CatoLynx/LAWO-Arduino/BOM.xlsx

Item | Qty | Reference(s) | Value | Order No. / URL | Supplier
1 | 3 | C3,C1,C4 | 100n | X7R-5 100N | reichelt
2 | 1 | C2 | 100u | RAD 100/25 | reichelt
3 | 1 | F1 | T500mA | RND 170-00041 | reichelt
4 | 1 | P1,P2 | POWER/DATA,LED | AKL 230-04 + AKL 249-04 | reichelt
5 | 1 | P3 | MATRIX | WSL 50G | reichelt
6 | 1 | P4 | MUX | WSL 20G | reichelt
7 | 1 | Q1 | BC547 | BC 547C | reichelt
8 | 1 | Q2 | IRF740 | IRF 740 | reichelt
9 | 4 | R5,R6,R1,R2 | 10k | 1/4W 10K | reichelt
10 | 1 | R3 | 240 | 1/4W 240 | reichelt
11 | 1 | R4 | 56 | 2W METALL 56 | reichelt
12 | 1 | RV1 | 5k | 64Y-5,0K | reichelt
13 | 1 | U1 | R-78E5.0-0.5 | R-78E50-05 | reichelt
14 | 1 | U2 | LM317T | LM 317-220 | reichelt
15 | 2 | U9,U3 | CD4514B | https://www.ebay.de/itm/110545119205 | eBay
16 | 2 | U5,U4 | ULN2803A | ULN 2803A | reichelt
17 | 1 | U6 | Arduino_Nano | https://www.ebay.de/itm/252742123829 | eBay
18 | 2 | U7,U8 | UDN2981A | UDN 2981 | reichelt
19 | 4 | U4,U5,U7,U8 | Sockel | GS 18 | reichelt
20 | 2 | U3,U9 | Sockel | GS 24 | reichelt
21 | 2 | U6 | Sockel | https://www.ebay.de/itm/172461135540 | eBay
22 | 1 | Q2 | Kühlkörper | 188158 | Conrad
