CatoLynx/LAWO-Arduino/Eigene Steuerplatine Line Decoder.pdf

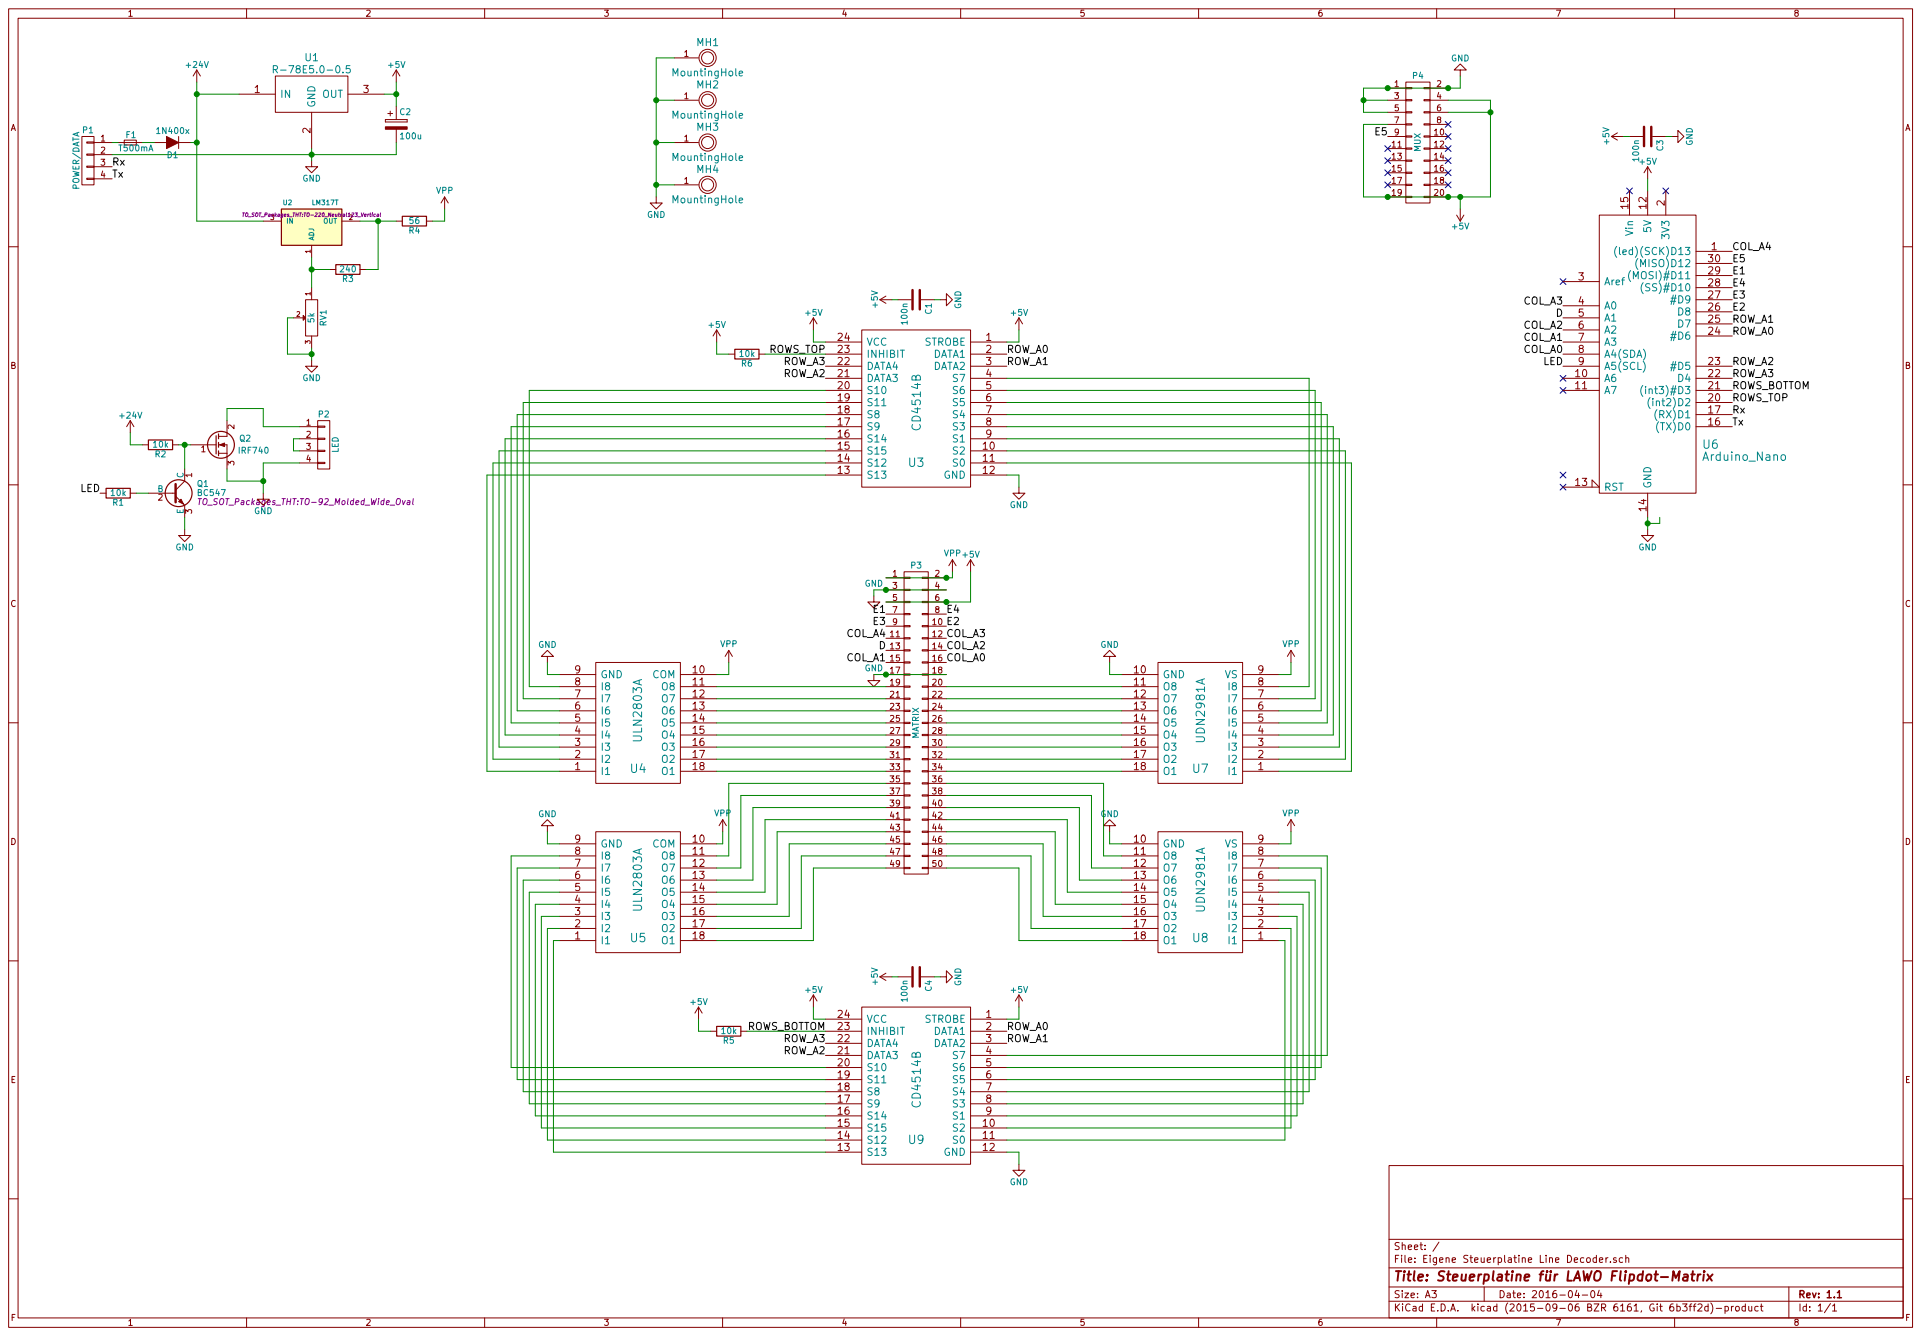
[picture p1: page 1]

10k +5V 1 MH1 MountingHole 1 MH2 MountingHole 1 MH3 MountingHole 1 MH4 MountingHole GND

COL_A2

21 | | 22
23 | | 24
25 | | 26
27 | | 28
29 | | 30
31 | | 32
33 | | 34
35 | | 36
37 | | 38
39 | | 40
41 | | 42
43 | | 44
45 | | 46
47 | | 48

Id: 1/1 Title: Steuerplatine für LAWO Flipdot-Matrix
