CatoLynx/LAWO-Arduino/Eigene Steuerplatine Line Decoder.kicad_pcb

## KiCad design Eigene Steuerplatine Line Decoder.kicad_pcb (2023-11-21)

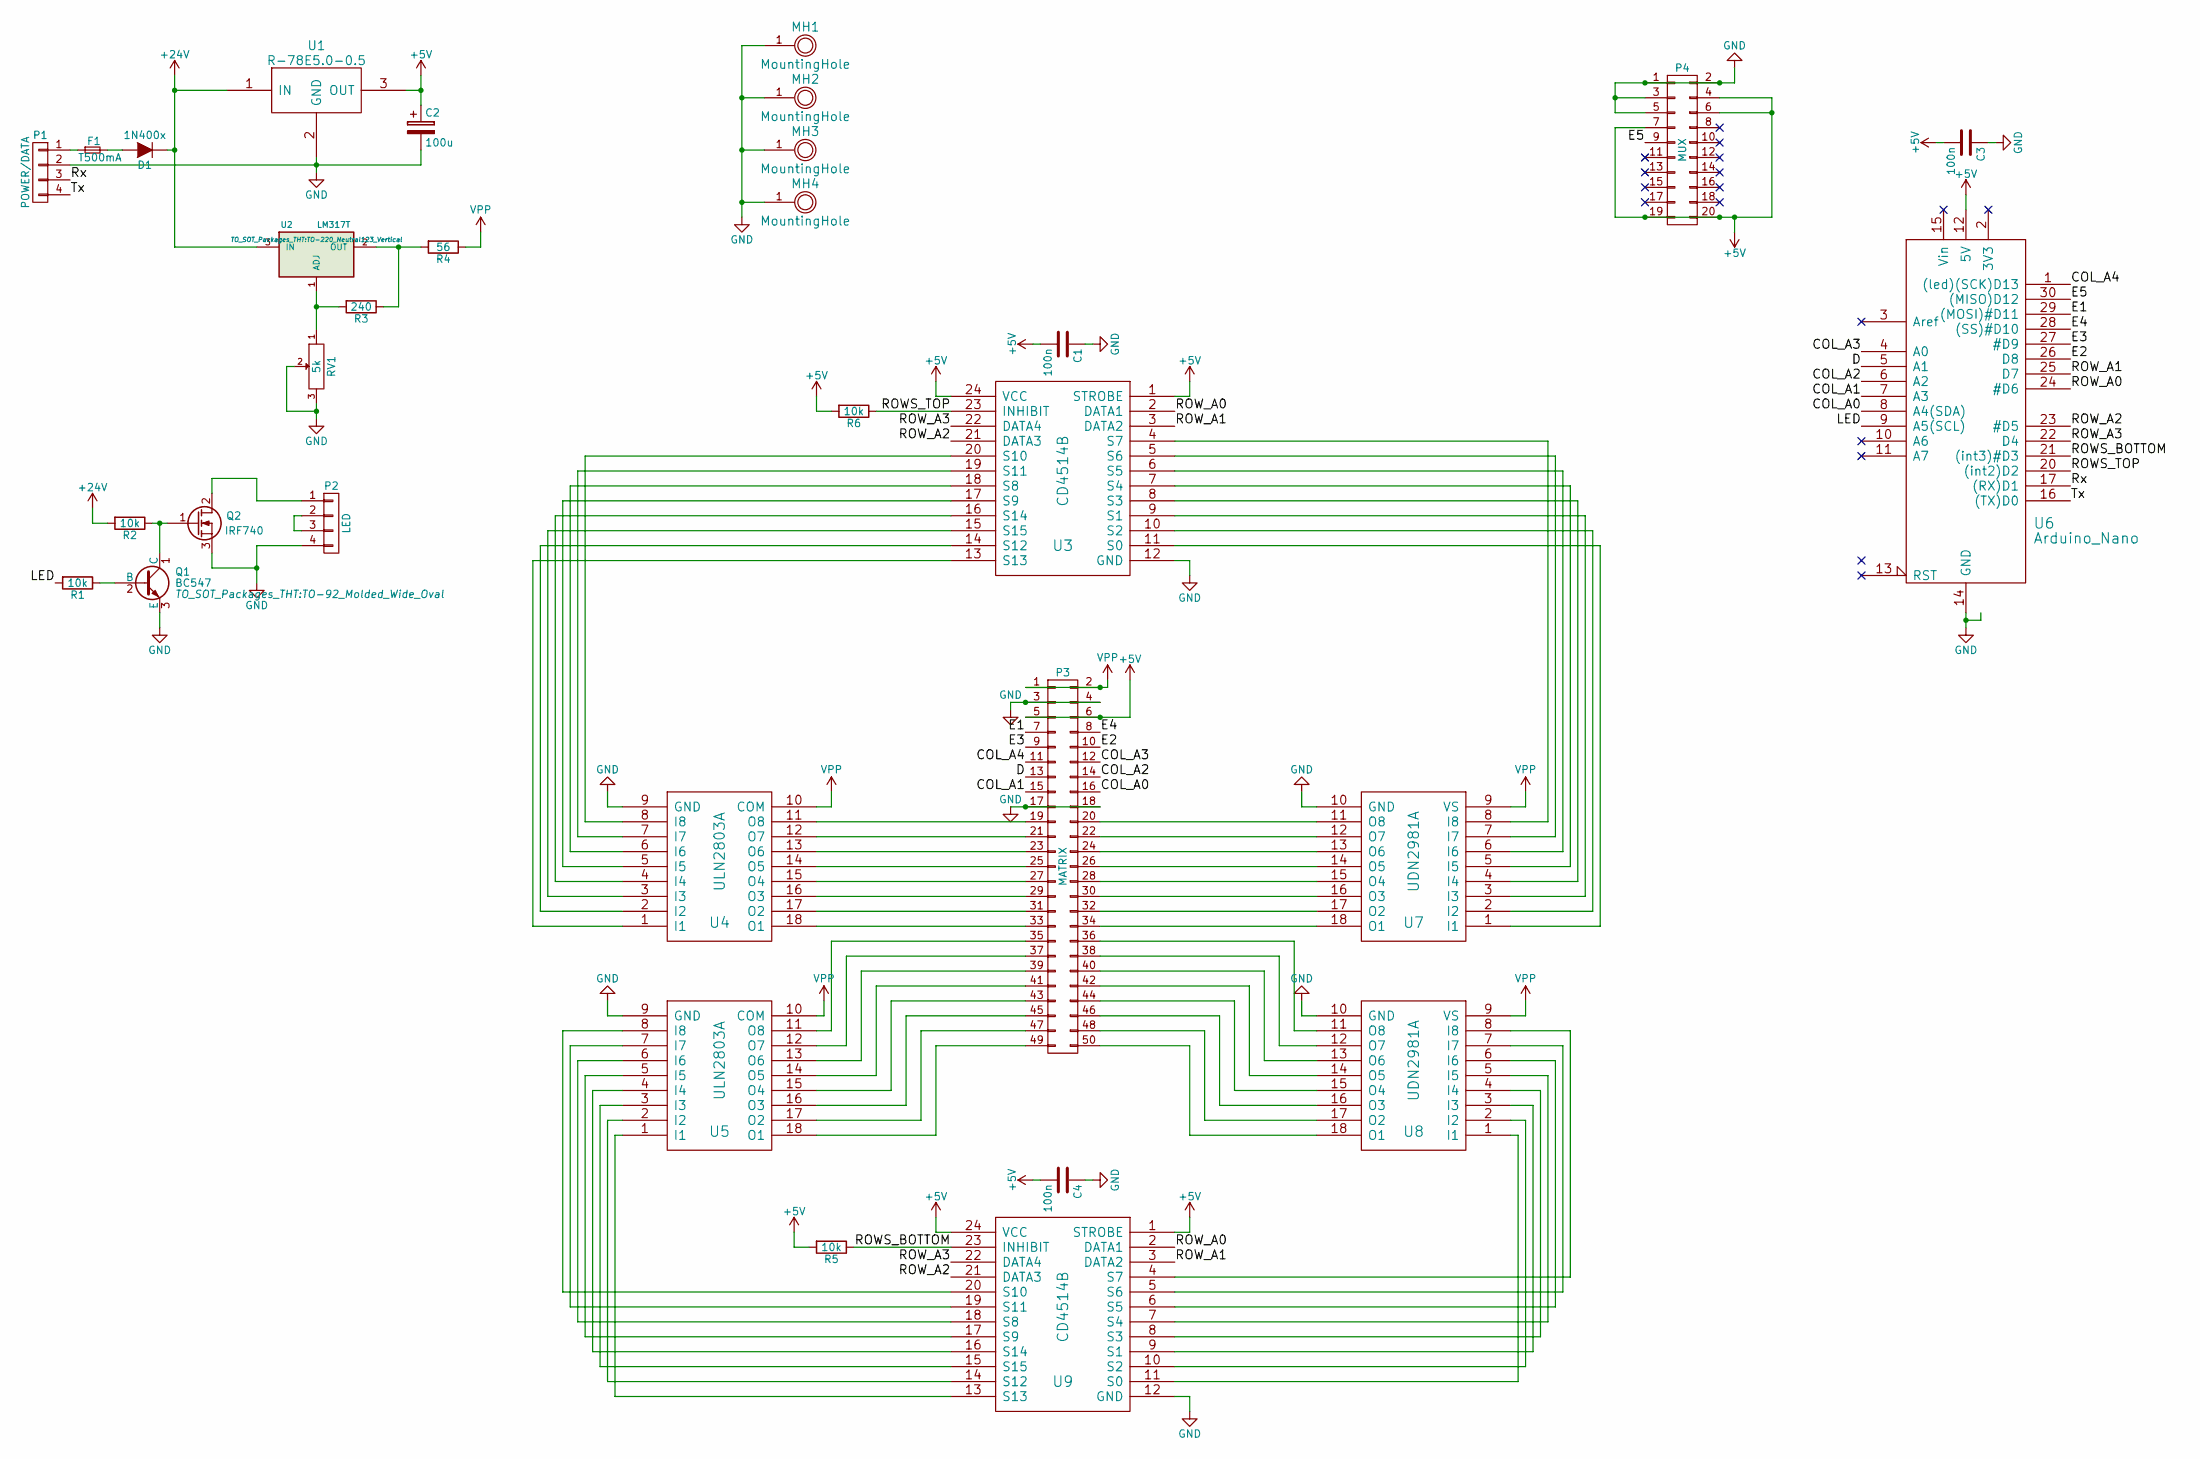
[picture p2: schematic Eigene Steuerplatine Line Decoder.kicad_sch, Steuerplatine für LAWO Flipdot-Matrix]

Parts:
C1, C3, C4: 100n; C_Rect_L7_W2.5_P5
C2: 100u; C_Radial_D5_L11_P2.5
D1: 1N400x; Diode_DO-35_SOD27_Horizontal_RM10
F1: T500mA; Fuseholder5x20_horiz_open_Schurter_0031_8201
MH1, MH2, MH3, MH4: MountingHole; 1pin
P1: POWER/DATA; Terminal_Conn_4pin_RM5.08
P2: LED; Terminal_Conn_4pin_RM5.08
P3: MATRIX; IDC_Header_Straight_50pins
P4: MUX; IDC_Header_Straight_20pins
Q1: BC547; TO-92_Molded_Wide_Oval
Q2: IRF740; TO-220_Neutral123_Vertical
R1, R2, R5, R6: 10k; Resistor_Horizontal_RM10mm
R3: 240; Resistor_Horizontal_RM10mm
R4: 56; Resistor_Horizontal_RM20mm
RV1: 5k; Potentiometer_Bourns_3296Y_3-8Zoll_Angular_ScrewUp
U1: R-78E5.0-0.5; DC_DC_Converter_W11.5_L8.5_P2.54
U2: LM317T; TO-220_Neutral123_Vertical
U3, U9: CD4514B; DIP-24_W15.24mm_LongPads
U4, U5: ULN2803A; DIP-18_W7.62mm_LongPads
U6: Arduino_Nano
U7, U8: UDN2981A; DIP-18_W7.62mm_LongPads

Connections:
+5V: C1.2, C2.1, C3.2, C4.2, P3.5, P3.6, P4.4, P4.6, P4.7, P4.19, P4.20, R5.2, R6.2, U1.3 (OUT), U3.1 (STROBE), U3.24 (VCC), U6.12 (5V), U9.1 (STROBE), U9.24 (VCC)
+24V: D1.1 (K), D1.2 (A), F1.2, R2.2, U1.1 (IN), U2.3 (IN)
/COL_A0: P3.16, U6.8 (A4(SDA))
/COL_A1: P3.15, U6.7 (A3)
/COL_A2: P3.14, U6.6 (A2)
/COL_A3: P3.12, U6.4 (A0)
/COL_A4: P3.11, U6.1 ((led)(SCK)D13)
/D: P3.13, U6.5 (A1)
/E1: P3.7, U6.29 ((MOSI)#D11)
/E2: P3.10, U6.26 (D8)
/E3: P3.9, U6.27 (#D9)
/E4: P3.8, U6.28 ((SS)#D10)
/E5: P4.9, U6.30 ((MISO)D12)
/LED: R1.2, U6.9 (A5(SCL))
/ROWS_BOTTOM: R5.1, U6.21 ((int3)#D3), U9.23 (INHIBIT)
/ROWS_TOP: R6.1, U3.23 (INHIBIT), U6.20 ((int2)D2)
/ROW_A0: U3.2 (DATA1), U6.24 (#D6), U9.2 (DATA1)
/ROW_A1: U3.3 (DATA2), U6.25 (D7), U9.3 (DATA2)
/ROW_A2: U3.21 (DATA3), U6.23 (#D5), U9.21 (DATA3)
/ROW_A3: U3.22 (DATA4), U6.22 (D4), U9.22 (DATA4)
/Rx: P1.3, U6.17 ((RX)D1)
/Tx: P1.4, U6.16 ((TX)D0)
GND: C1.1, C2.2, C3.1, C4.1, MH1.1, MH2.1, MH3.1, MH4.1, P1.2, P2.4, P3.3, P3.4, P3.17, P3.18, P4.1, P4.2, P4.3, P4.5, Q1.3 (E), Q2.3 (S), RV1.2, RV1.3, U1.2 (GND), U3.12 (GND), U4.9 (GND), U5.9 (GND), U6.14 (GND), U6.19 (GND), U7.10 (GND), U8.10 (GND), U9.12 (GND)
unnamed: F1.1, P1.1
unnamed: P2.1, Q2.2 (D)
unnamed: P2.2, P2.3
unnamed: P3.19, U4.11 (O8)
unnamed: P3.20, U7.11 (O8)
unnamed: P3.21, U4.12 (O7)
unnamed: P3.22, U7.12 (O7)
unnamed: P3.23, U4.13 (O6)
unnamed: P3.24, U7.13 (O6)
unnamed: P3.25, U4.14 (O5)
unnamed: P3.26, U7.14 (O5)
unnamed: P3.27, U4.15 (O4)
unnamed: P3.28, U7.15 (O4)
unnamed: P3.29, U4.16 (O3)
unnamed: P3.30, U7.16 (O3)
unnamed: P3.31, U4.17 (O2)
unnamed: P3.32, U7.17 (O2)
unnamed: P3.33, U4.18 (O1)
unnamed: P3.34, U7.18 (O1)
unnamed: P3.35, U5.11 (O8)
unnamed: P3.36, U8.11 (O8)
unnamed: P3.37, U5.12 (O7)
unnamed: P3.38, U8.12 (O7)
unnamed: P3.39, U5.13 (O6)
unnamed: P3.40, U8.13 (O6)
unnamed: P3.41, U5.14 (O5)
unnamed: P3.42, U8.14 (O5)
unnamed: P3.43, U5.15 (O4)
unnamed: P3.44, U8.15 (O4)
unnamed: P3.45, U5.16 (O3)
unnamed: P3.46, U8.16 (O3)
unnamed: P3.47, U5.17 (O2)
unnamed: P3.48, U8.17 (O2)
unnamed: P3.49, U5.18 (O1)
unnamed: P3.50, U8.18 (O1)
unnamed: Q1.1 (C), Q2.1 (G), R2.1
unnamed: Q1.2 (B), R1.1
unnamed: R3.1, R4.2, U2.2 (OUT)
unnamed: R3.2, RV1.1, U2.1 (ADJ)
unnamed: U3.4 (S7), U7.8 (I8)
unnamed: U3.5 (S6), U7.7 (I7)
unnamed: U3.6 (S5), U7.6 (I6)
unnamed: U3.7 (S4), U7.5 (I5)
unnamed: U3.8 (S3), U7.4 (I4)
unnamed: U3.9 (S1), U7.3 (I3)
unnamed: U3.10 (S2), U7.2 (I2)
unnamed: U3.11 (S0), U7.1 (I1)
unnamed: U3.13 (S13), U4.1 (I1)
unnamed: U3.14 (S12), U4.2 (I2)
unnamed: U3.15 (S15), U4.3 (I3)
unnamed: U3.16 (S14), U4.4 (I4)
unnamed: U3.17 (S9), U4.5 (I5)
unnamed: U3.18 (S8), U4.6 (I6)
unnamed: U3.19 (S11), U4.7 (I7)
unnamed: U3.20 (S10), U4.8 (I8)
unnamed: U5.1 (I1), U9.13 (S13)
unnamed: U5.2 (I2), U9.14 (S12)
unnamed: U5.3 (I3), U9.15 (S15)
unnamed: U5.4 (I4), U9.16 (S14)
unnamed: U5.5 (I5), U9.17 (S9)
unnamed: U5.6 (I6), U9.18 (S8)
unnamed: U5.7 (I7), U9.19 (S11)
unnamed: U5.8 (I8), U9.20 (S10)
unnamed: U8.1 (I1), U9.11 (S0)
unnamed: U8.2 (I2), U9.10 (S2)
unnamed: U8.3 (I3), U9.9 (S1)
unnamed: U8.4 (I4), U9.8 (S3)
unnamed: U8.5 (I5), U9.7 (S4)
unnamed: U8.6 (I6), U9.6 (S5)
unnamed: U8.7 (I7), U9.5 (S6)
unnamed: U8.8 (I8), U9.4 (S7)
VPP: P3.1, P3.2, R4.1, U4.10 (COM), U5.10 (COM), U7.9 (VS), U8.9 (VS)

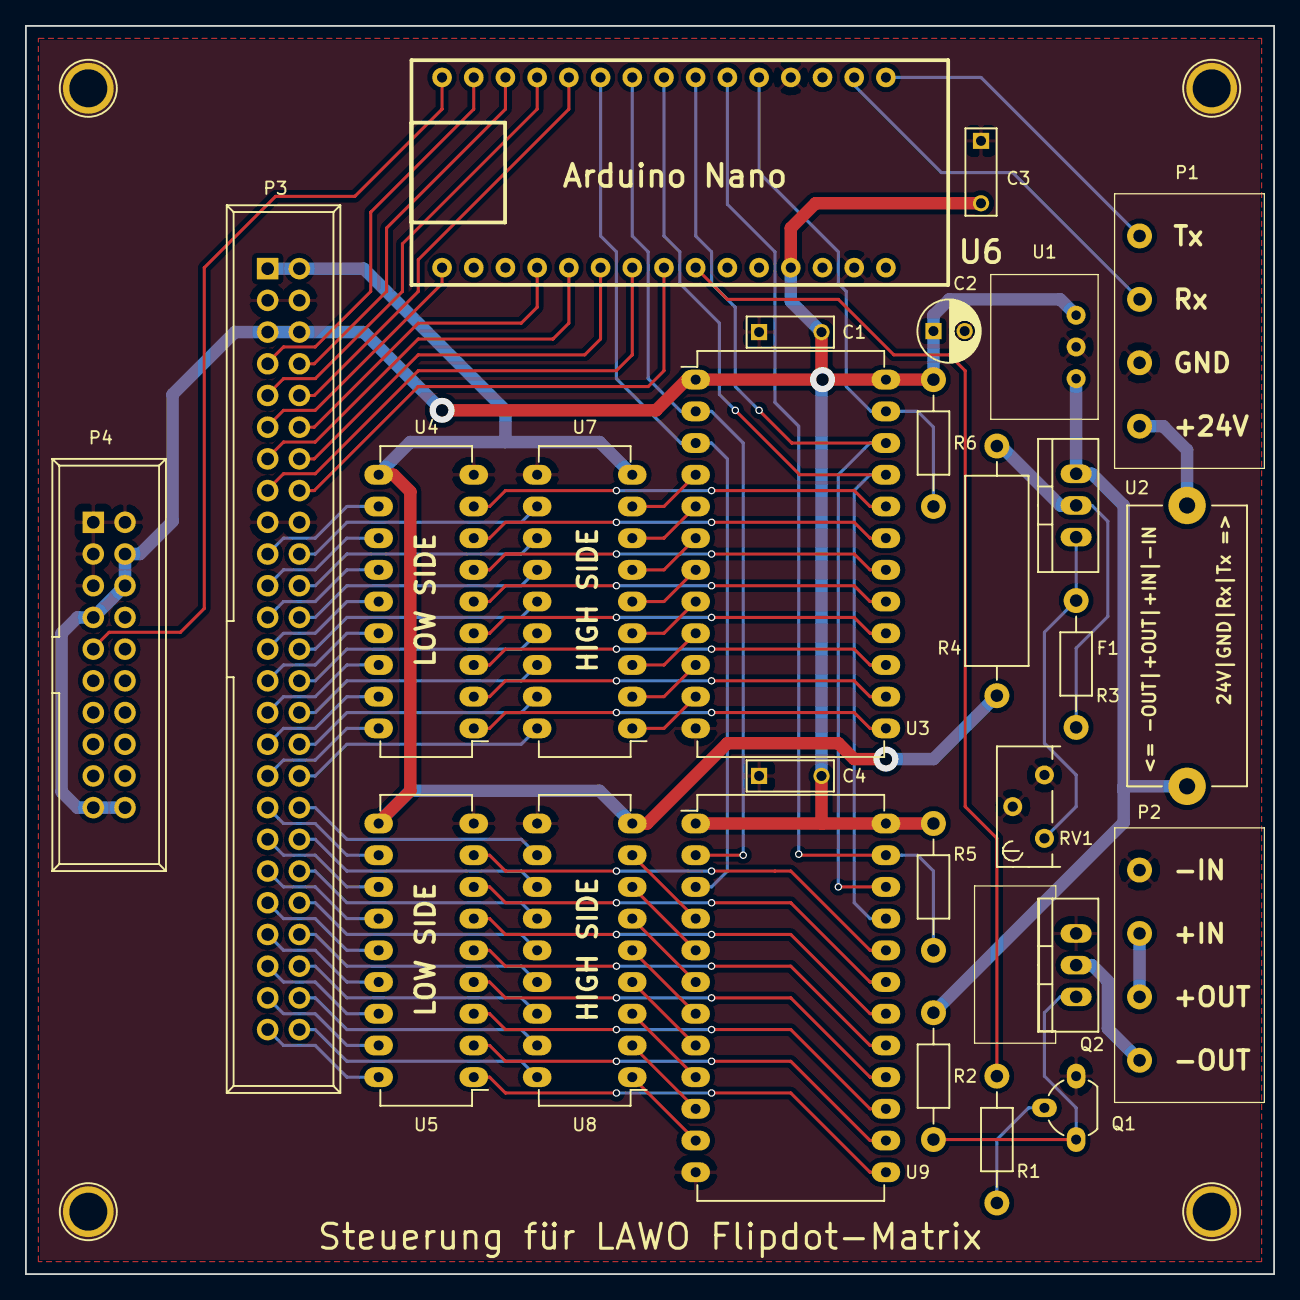
[picture p3: board Eigene Steuerplatine Line Decoder.kicad_pcb from above]

Board: 2 copper layers, 100.0 x 100.0 mm, 31 parts (0 on the bottom side), 95 nets.
