CatoLynx/LAWO-Arduino/(commit log)

2020-04-20 Initial version
    [Eigene Steuerplatine Line Decoder.csv, Eigene Steuerplatine Line Decoder.kicad_pcb, Eigene Steuerplatine Line Decoder.sch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]
2023-11-21 Convert to KiCad 7 project
    [BOM.xlsx, Eigene Steuerplatine Line Decoder.kicad_pcb, Eigene Steuerplatine Line Decoder.kicad_sch, Eigene Steuerplatine Line Decoder.sch]
